pwuertz/faout/(commit log)

2014-05-16 Begin hardware layout.
    [faout.brd, faout.sch]
2014-05-19 Development of FAout hardware.
    [faout.brd, faout.sch]
2014-05-22 More ADC research.
2014-05-23 Add DAC converters.
    [faout.brd, faout.sch]
2014-05-25 Connected DACs to power and FPGA.
    [faout.brd, faout.sch]
2014-05-26 Add parts for ADC conversion.
    [faout.brd, faout.sch]
2014-05-27 Reroute USB
    [faout.brd]
2014-05-27 Finalize USB and ADC layout.
    [faout.brd, faout.sch]
2014-05-27 Added 7-segment display.
    [faout.brd, faout.sch]
2014-05-28 Finished User IO, create new power supply.
    [faout.brd, faout.sch]
2014-05-29 Finalize design.
    [faout.brd, faout.sch]
2014-05-29 Unify analog regulators.
    [faout.brd, faout.sch]
2014-05-29 Rearrange labels
    [faout.brd, faout.sch]
2014-05-29 Cleanup and last adjustments.
    [faout.brd, faout.sch]
2014-06-02 Fix display orientation and start production.
    [faout.brd, faout.sch]
2014-06-04 Cover vias under USB connector.
    [faout.brd]
2014-06-24 Fix DAC voltage ref oscillations in next board version.
    [faout.brd, faout.sch]
2014-06-25 Larger SMD pads and optional capacitors.
    [faout.brd, faout.sch]
2014-07-04 Add VHDL components for FAOUT board.
2014-08-19 Sample distribute design stalled when FIFO was empty. Fixed.
2014-10-22 WIP: Design 6channel FAOUT prototype.
    [faout.brd, faout.sch]
2014-10-23 WIP: Compress FAOUT-6 layout to 7cm, use space for connectors.
    [faout.brd, faout.sch]
2014-10-27 Order code corrections and additions.
    [faout.brd, faout.sch]
2014-10-28 Update UCF file for new board layout.
    [faout.brd, faout.sch]
2014-10-30 Cleanup layout.
    [faout.brd]
2014-10-31 Add xsvf file for flashing board using firmware version 48.
2014-11-05 Fix output channel numbering in firmware.
    [top_level.vhd]
2015-01-22 Add sequence-arm command and auto-arm configuration flag.
2015-01-23 Rework DAC power supply. Precision resistor arrays for outputs.
    [faout.brd, faout.sch]
2015-01-23 Analog power supply with low profile components.
    [faout.brd, faout.sch]
2015-01-23 Add and correct Farnell order codes.
    [faout.brd, faout.sch]
2015-02-17 Attempt to fix sequence startup bug in firmware 52.
    [top_level.vhd]
2015-02-18 Replace old sequencer with a register based packet processor.
    [sequencer.vhd, sequencer_pkg.vhd, sequencer_tb.vhd]
2015-02-20 Redesign faout firmware for using top level register / new sequencer approach.
    [sequencer.vhd, sequencer_tb.vhd, top_level.vhd]
2015-02-27 Fix SDRAM to FIFO transfer. Don't auto-reset sequence on error.
    [top_level.vhd]
2015-03-02 Replace USB connector. Minor changes for production.
    [faout.brd, faout.sch]
2015-05-05 Modify board for 256Mbit DRAM (MT48LC16M16) compatibility.
    [faout.brd, faout.sch]
2015-05-18 Ported faout firmware to new framework.
2015-06-11 Positioning of part labels.
    [faout.brd]
